zaitldav/SmartHydroponics/README.md

# SmartHydroponics
A controller for small autonomous hydroponics.

## Mindmap
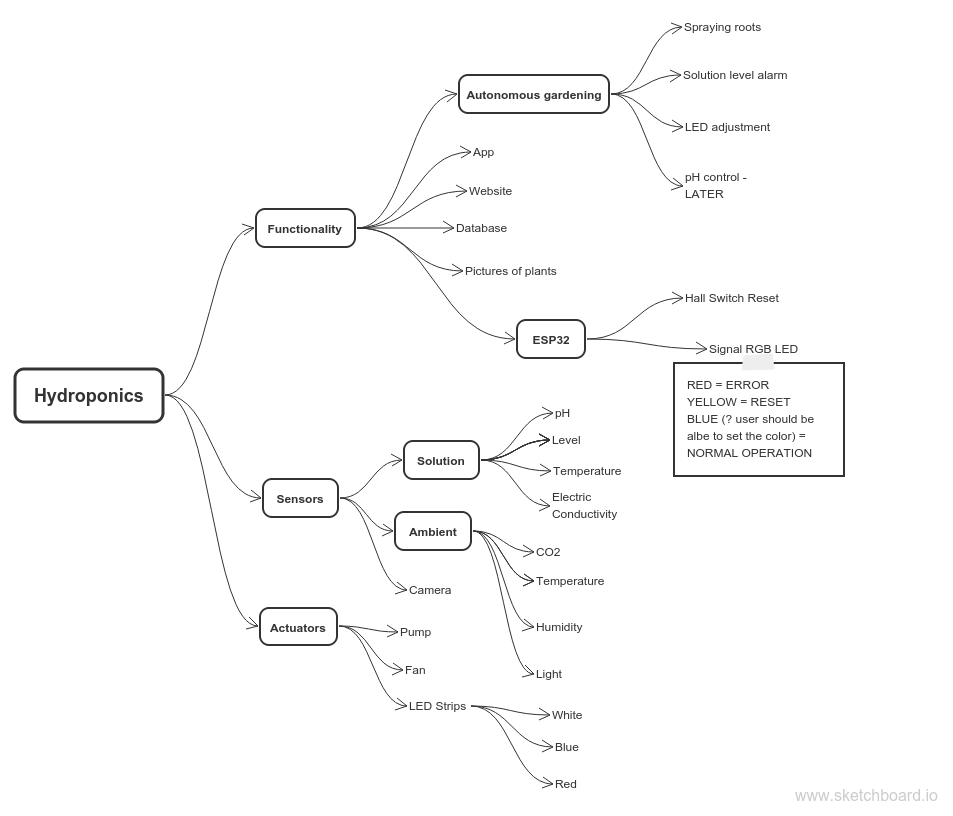
[picture p1: mindmap.png]
Mindmap MINDMAP
