zaitldav/SmartHydroponics/Hardware/SmartHydroponics.kicad_pcb

## KiCad design Hardware/SmartHydroponics.kicad_pcb (2019-07-19)

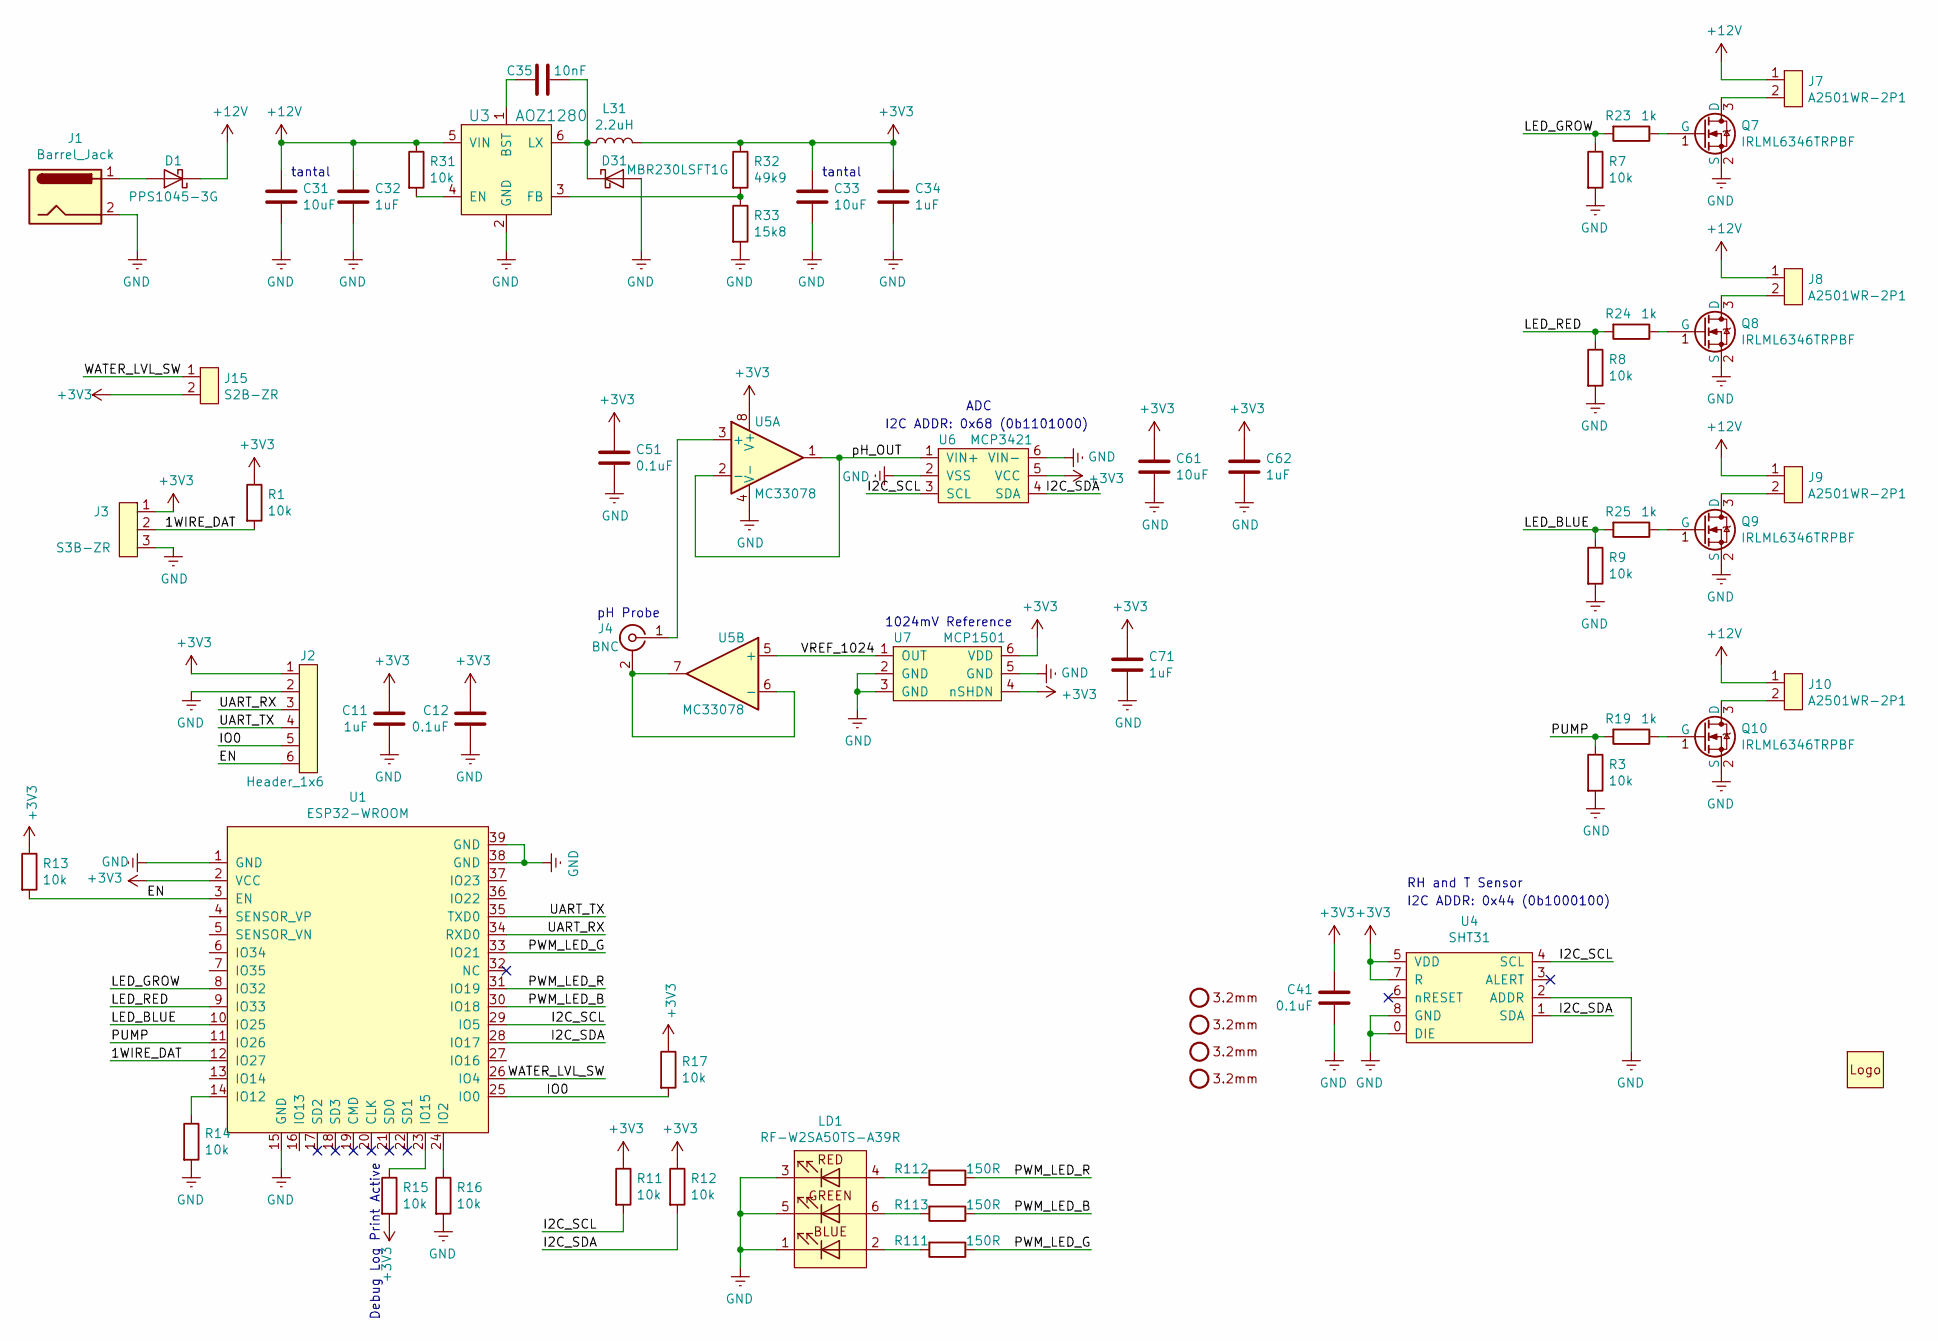
[picture p2: schematic SmartHydroponics.sch, Plant Monitoring Device]

Parts:
C11, C32, C34, C62, C71: 1uF; C0603
C12, C41, C51: 0.1uF; C0603
C31, C33, C61: 10uF; C1210
C35: 10nF; C0603
D1: PPS1045-3G; TO-277-3
D31: MBR230LSFT1G; SOD-123
H1, H2, H3, H4: Mounting_hole_unplated_3,2mm
H111: Mr_Gardener_Logo_Small; mr_hydrogardener_logo_12mm
J1: Barrel_Jack; BarrelJack_Horizontal
J2: Header_1x6; Header_1x06_P2.54mm
J3: S3B-ZR
J4: BNC; TE_BNC
J7, J8, J9, J10: A2501WR-2P1
J15: S2B-ZR
L31: 2.2uH; L1210
LD1: RF-W2SA50TS-A39R
Q7, Q8, Q9, Q10: IRLML6346TRPBF; SOT-23
R1, R3, R7, R8, R9, R11, R12, R13, R14, R15, R16, R17, R31: 10k; R0603
R19, R23, R24, R25: 1k; R0603
R32: 49k9; R0603
R33: 15k8; R0603
R111, R112, R113: 150R; R0603
U1: ESP32-WROOM
U3: AOZ1280; SOT-23-6
U4: SHT31
U5: MC33078; SOIC-8
U6: MCP3421; SOT-23-6
U7: MCP1501; SOT-23-6

Connections:
+3V3: C11.1, C12.1, C33.1, C34.1, C41.1, C51.1, C61.1, C62.1, C71.1, J2.1, J3.1, J15.2, L31.2, R1.1, R11.1, R12.1, R13.1, R15.2, R17.1, R32.1, U1.2 (VCC), U4.5 (VDD), U4.7 (R), U5.8 (V+), U6.5 (VCC), U7.4 (nSHDN), U7.6 (VDD)
+12V: C31.1, C32.1, D1.1 (K), J7.1, J8.1, J9.1, J10.1, R31.1, U3.5 (VIN)
/1WIRE_DAT: J3.2, R1.2, U1.12 (IO27)
/EN: J2.6, R13.2, U1.3 (EN)
/I2C_SCL: R11.2, U1.29 (IO5), U4.4 (SCL), U6.3 (SCL)
/I2C_SDA: R12.2, U1.28 (IO17), U4.1 (SDA), U6.4 (SDA)
/IO0: J2.5, R17.2, U1.25 (IO0)
/LED_BLUE: R9.1, R25.2, U1.10 (IO25)
/LED_GROW: R7.1, R23.2, U1.8 (IO32)
/LED_RED: R8.1, R24.2, U1.9 (IO33)
/PUMP: R3.1, R19.2, U1.11 (IO26)
/PWM_LED_B: R113.1, U1.30 (IO18)
/PWM_LED_G: R111.1, U1.33 (IO21)
/PWM_LED_R: R112.1, U1.31 (IO19)
/UART_RX: J2.3, U1.34 (RXD0)
/UART_TX: J2.4, U1.35 (TXD0)
/VREF_1024: U5.5 (+), U7.1 (OUT)
/WATER_LVL_SW: J15.1, U1.26 (IO4)
/pH_OUT: U5.1, U5.2 (-), U6.1 (VIN+)
GND: C11.2, C12.2, C31.2, C32.2, C33.2, C34.2, C41.2, C51.2, C61.2, C62.2, C71.2, D31.2 (A), J1.2, J2.2, J3.3, LD1.1 (K), LD1.3 (K), LD1.5 (K), Q7.2 (S), Q8.2 (S), Q9.2 (S), Q10.2 (S), R3.2, R7.2, R8.2, R9.2, R14.2, R16.2, R33.2, U1.1 (GND), U1.15 (GND), U1.38 (GND), U1.39 (GND), U3.2 (GND), U4.0 (DIE), U4.2 (ADDR), U4.8 (GND), U5.4 (V-), U6.2 (VSS), U6.6 (VIN-), U7.2 (GND), U7.3 (GND), U7.5 (GND)
unnamed: C35.1, U3.1 (BST)
unnamed: C35.2, D31.1 (K), L31.1, U3.6 (LX)
unnamed: D1.2 (A), J1.1
unnamed: J4.1 (In), U5.3 (+)
unnamed: J4.2 (Ext), U5.6 (-), U5.7
unnamed: J7.2, Q7.3 (D)
unnamed: J8.2, Q8.3 (D)
unnamed: J9.2, Q9.3 (D)
unnamed: J10.2, Q10.3 (D)
unnamed: LD1.2 (A), R111.2
unnamed: LD1.4 (A), R112.2
unnamed: LD1.6 (A), R113.2
unnamed: Q7.1 (G), R23.1
unnamed: Q8.1 (G), R24.1
unnamed: Q9.1 (G), R25.1
unnamed: Q10.1 (G), R19.1
unnamed: R14.1, U1.14 (IO12)
unnamed: R15.1, U1.23 (IO15)
unnamed: R16.1, U1.24 (IO2)
unnamed: R31.2, U3.4 (EN)
unnamed: R32.2, R33.1, U3.3 (FB)

Notes on the sheet:
tantal
Debug Log Print Active
I2C ADDR: 0x68 (0b1101000)
ADC
1024mV Reference
pH Probe
I2C ADDR: 0x44 (0b1000100)
RH and T Sensor

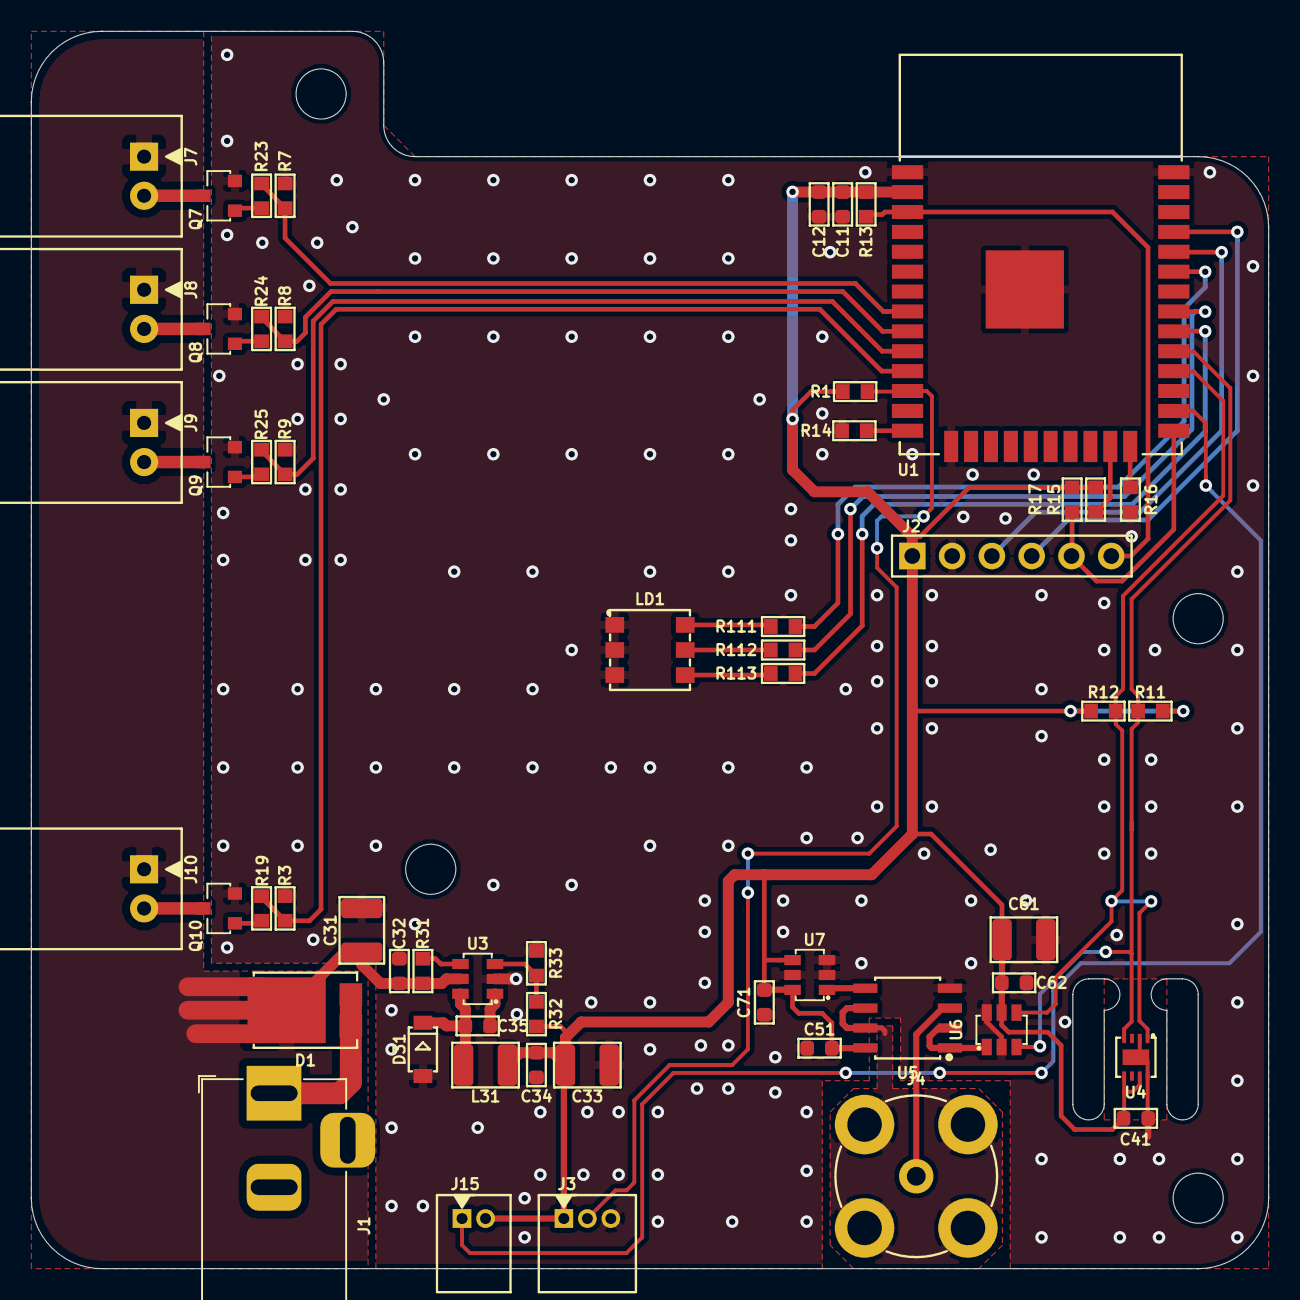
[picture p3: board SmartHydroponics.kicad_pcb from above]

Board: 2 copper layers, 79.0 x 79.0 mm, 62 parts (1 on the bottom side), 41 nets.
