zaitldav/SmartHydroponics/(threads)

Thread 1 (2019-06-21):

Find an ADC for pH measurement

zaitldav, 2019-06-21:
The ESP32 has noisy and bad ADC.
Use an external ADC instead.

The ADC must have either its internal Vref or at least Vref pin.

Perhaps:
 * MCP3201-CI/MS
 * MCP3201-CI/SN
 * MCP3425A0T-ECH
 * or similar

zaitldav, 2019-06-26:
Maybe MCP3421 - it has I2C and on-board voltage reference

Closed 2019-06-27.
