zaitldav/SmartHydroponics/(commit log)

2019-06-28 Created folder for hardware. Started to design the schematics.
    [Smart_Hydroponics.kicad_pcb, Smart_Hydroponics.sch, _saved_Smart_Hydroponics.sch]
2019-06-28 Changes in schematics I didn't push before by accident.
    [Smart_Hydroponics.sch, _saved_Smart_Hydroponics.sch]
2019-07-19 Finished design of the hydroponics controler. Generated Gerbers.
    [SmartHydroponics-B.Cu.gbr, SmartHydroponics-B.Mask.gbr, SmartHydroponics-B.Paste.gbr, SmartHydroponics-B.SilkS.gbr, SmartHydroponics-Edge.Cuts.gbr, SmartHydroponics-F.Cu.gbr, SmartHydroponics-F.Mask.gbr, SmartHydroponics-F.Paste.gbr]
2020-12-07 I do not remember. Sorry. Forgot to push. Sincerely Past David.
    [SmartHydroponics-B.Cu.gbr, SmartHydroponics-B.Mask.gbr, SmartHydroponics-B.Paste.gbr, SmartHydroponics-B.SilkS.gbr, SmartHydroponics-Edge.Cuts.gbr, SmartHydroponics-F.Cu.gbr, SmartHydroponics-F.Mask.gbr, SmartHydroponics-F.Paste.gbr]
